theo-michel/clippy-picker/docs/bench-setup.png

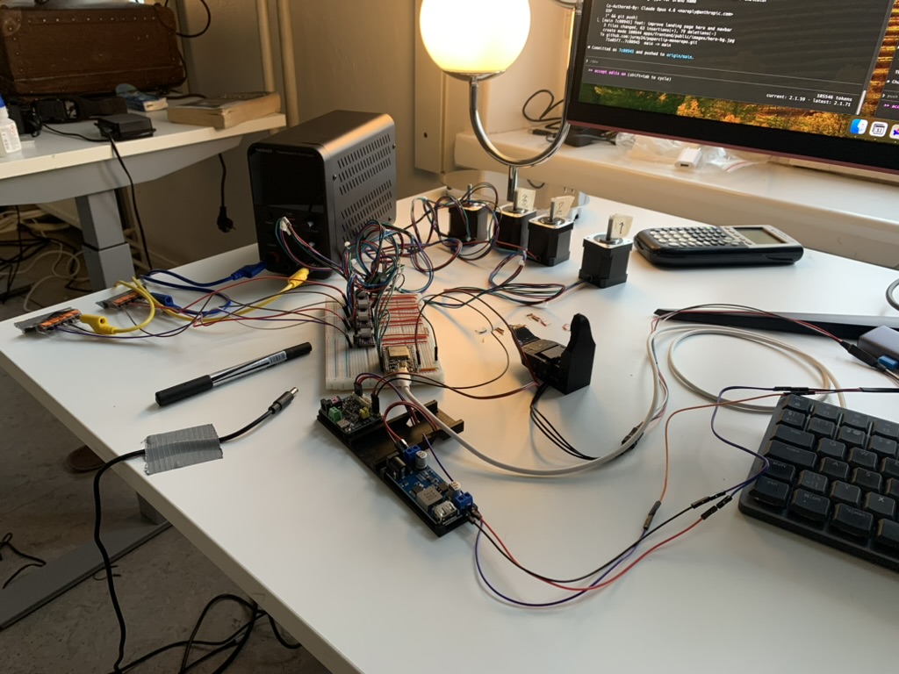
docs/bench-setup.png
