theo-michel/clippy-picker/docs/waveshare-adapter-wrong-not-uart-servo.png

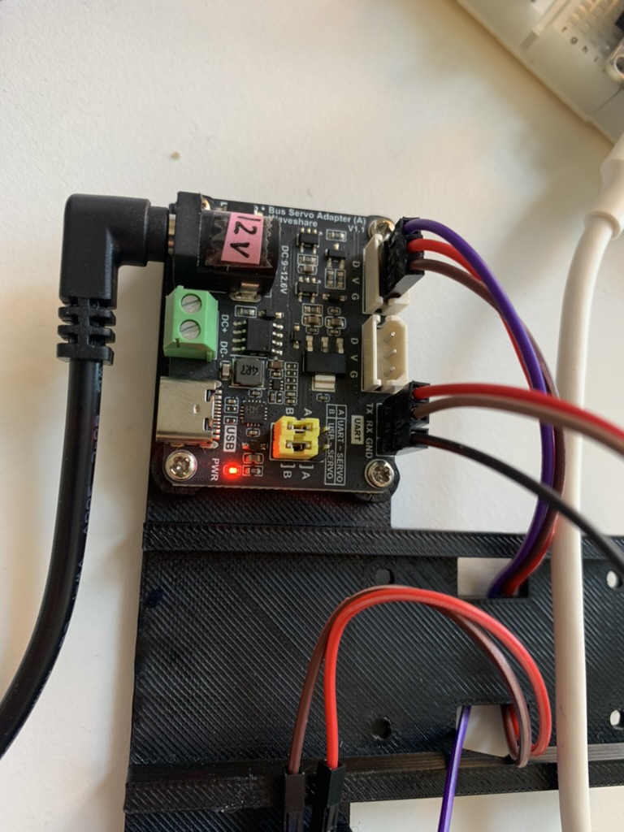
docs/waveshare-adapter-wrong-not-uart-servo.png
