theo-michel/clippy-picker/firmware/include/gripper.h

#pragma once

#include <stdint.h>
#include "config.h"

/// Feetech STS3215 gripper control over Serial2.
///
/// Provides open/close, arbitrary position control, and telemetry
/// readback (position, temperature, load).
class Gripper {
public:
    bool init();

    void open();
    void close();
    void setPosition(int32_t pos);

    int32_t getPosition();
    int32_t getTemperature();   // °C
    int32_t getLoad();          // raw current register value (mA)
    bool    isMoving();

    bool isConnected();

private:
    bool _probe();
    bool _connected = false;
};

extern Gripper gripper;
