theo-michel/clippy-picker/(commit log)

2026-02-09 Initial commit: Delta robot controller
    Arduino firmware and Python web interface for delta robot kinematics and control.
2026-02-09 Update kinematics, web controller, and HTML templates
2026-02-18 addded small arm at the bottom
2026-03-02 ♻️ replace pip with uv
2026-03-02 ✨ add calibration file
2026-03-05 ✨ create firmware test code with esp32 and 4 steppers
2026-03-08 ✨ set up working operation for all 4 motors + gripper
2026-03-08 ✨ write firmware (untested)
2026-03-09 ✨ create wifi test for esp32
2026-04-02 ✨ add gantry homing, delta enable/disable, and endstop support
    Add gantry endstop homing (move toward limit switch, set zero, back off),
    delta motor enable/disable via DRV8825 EN pin, and new serial commands
    (GANTRY_HOME, DELTA_ENABLE, DELTA_DISABLE). Update config with endstop
    pin, enable pin, corrected limits, and faster gantry speed defaults.
    Made-with: Cursor
    [config.h, motors.cpp, motors.h, protocol.cpp, protocol.h]
2026-04-02 ✨ add gripper test scripts and rewrite endstop test
    Add Dynamixel gripper test (gripper_test.cpp) and raw serial gripper test
    (gripper_raw_test.cpp) with platformio environments. Rewrite endstop test
    with interactive jogging (a/d/s/h/p), proper homing with back-off, and
    position tracking in mm.
    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
2026-04-02 ✨ add forward kinematics, coordinates module, and updated geometry
    Add forward kinematics solver (three-sphere intersection). Remove redundant
    triangles IK method, keeping only the classic approach. Add coordinates.py
    for unified firmware↔kinematic angle conversion and robot geometry defaults
    (upper_arm=150, lower_arm=268, Fd=82.5, Ed=27.3). Document joint angle
    convention (0° = horizontal, positive = down).
    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
2026-04-02 ♻️ rewrite delta_robot driver with IK integration and telemetry
    Complete rewrite: add host-side inverse kinematics (move_to_xyz,
    move_to_position), firmware↔kinematic angle conversion, structured
    telemetry (Telemetry dataclass with Dynamixel state), gantry homing,
    delta enable/disable, and blocking move helpers. Replace raw send()
    with typed command methods and proper error handling.
    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
    [delta_robot.py]
2026-04-02 ✨ add homing system with persistent home offsets
    Add homing module (run_homing_sequence, load/save home offsets from
    delta_home.json), and homing web UI template for manual homing workflow.
    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
2026-04-02 ♻️ overhaul web controller and UI
    Rewrite web controller with homing routes, telemetry endpoint, Cartesian
    move support, and delta enable/disable. Rebuild index.html with updated
    controls for the new motion API and coordinate system.
    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
2026-04-02 ✨ add workspace analysis and update calibration geometry
    Add workspace_analysis.py for mapping reachable delta workspace with
    visualization output. Update calibration.py default geometry to match
    actual robot dimensions (lower_arm=268, Fd=82.5, Ed=27.3).
    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
2026-04-02 📝 update README with homing docs, new commands, and corrected limits
    Document GANTRY_HOME command, homing workflow for gantry/delta/gripper,
    correct Z-axis direction (down), and update gantry max travel to 500 mm.
    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
2026-04-02 ✨ add STS3215 serial servo test script
    Add test script for STS3215 serial bus servo with SCServo library
    and corresponding platformio environment.
    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
2026-04-04 Replace Dynamixel gripper with Feetech STS3215 and add real-time slider control
    Swap XL330 Dynamixel for STS3215 Feetech servo across firmware and Python:
    rewrite gripper.cpp with SCServo library, update config/pins/positions,
    add retry logic to gripper init, and report GRIPPER_DISCONNECTED on failure.
    Add gripper slider + open/close buttons to dashboard, /api/grip endpoint,
    gripper cycling in rectangle sweep, and throttled real-time slider sends.
    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
    [config.h, coordinates.py, delta_robot.py, feetech_test.py, gripper.cpp, gripper.h, protocol.cpp]
2026-04-06 ✨ get camera working with windows
2026-04-06 🧩 update pins for motors for pcb design
2026-04-10 test realsense camera on bjorns computer
2026-04-11 🧩 remove legacy arduino controller
2026-04-11 🧩 update microstepping to 1/16 and update firmware angles
2026-04-11 📝 remove unnecessary documentation
2026-04-11 ✨ update homing and zeroing kinematics in code
2026-04-11 🔧 remove legacy code for dynamixel servo
2026-04-11 add camera intrinsics to gitignore (stored on bjorns computer)
2026-04-11 remove delta_home.json persistence — home angles are fixed constants
    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
    [coordinates.py, delta_robot.py, web_controller.py]
2026-04-11 ✨ add calibration UI
2026-04-12 fix forward kinematics to use effective radius (Fd - Ed)
    The elbow-to-effector sphere centres should be offset by the effective radius f = Fd - Ed, not Fd alone. This makes the FK trilateration solve directly for the effector centre.
    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
    [delta_kinematics.py]
2026-04-12 redesign calibration UI with light theme, axis swap, and home position
    Switch from dark to light theme matching the dashboard. Swap canvas axes so Y is horizontal and X is vertical, flip Y direction. Load home position from server via new /api/home_xyz endpoint and use it for Z slider limits and Home button.
    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
    [web_controller.py]
2026-04-12 fix coordinate frame: +X toward arm 1, +Z down, +Y right-hand
    Rewrites kinematics and all UI/API code to use the correct physical frame. Fixes pre-existing FK sign bug in the quadratic solver that was masked by symmetric test cases. Corrects arm 2/3 rotation order to match physical motor layout (arm 2 at +120 deg from arm 1, clockwise from above).
    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
    [coordinates.py, delta_kinematics.py, delta_robot.py, web_controller.py]
2026-04-12 fix gripper connection by lowering USB serial baud to 115200
    Running both UART0 and UART2 at 1 Mbaud caused the servo ping to fail during startup. Dropping USB serial to 115200 (matching the working test script) resolves the issue. Also removes obsolete gripper test scripts.
    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
    [config.h, delta_robot.py]
2026-04-12 merge calibration + homing wizard into single dashboard page
    Consolidate the three separate pages (dashboard, calibration, homing)
    into one full-viewport dashboard with:
    - Homing wizard as a modal (triggered from topbar button)
    - Camera feed + XY workspace with Z lever and gantry slider
    - Gripper, computed angles, and actions in a controls row
    - Client-side IK engine for live drag-to-move
    - /homing and /calibration routes now redirect to /
    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
2026-04-12 ✨ add calibration and new UX
2026-04-13 perform an extrinsic camera calibration (poor rmsd)
2026-04-13 add automatic calibration script
2026-04-13 remove unused code across python and firmware
    - remove unused imports (make_transform, field, math, Tuple)
    - remove dead home_full() method from DeltaRobot (web controller calls run_homing_sequence directly)
    - remove unused DEFAULT_HOME constant from coordinates
    - remove unused NUM_MOTORS define from firmware config
    - delete scripts/calibration.py (outdated standalone script)
    - move kabsch into calibration/ and delete transforms.py
    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
2026-04-13 add YOLO object detection with tray-based pick flow
    - ObjectDetector wraps YOLOv11n with lazy loading and custom weight support
    - camera_to_robot() loads saved calibration transform for coord conversion
    - TrayRegion definitions (world-frame mm) for 6-tray 2x3 grid layout
    - /api/detect/scan and /api/detect/pick endpoints with tray filtering
    - TCP motion methods on DeltaRobot (move_tcp, move_to_position_tcp)
    - Detection overlay on MJPEG camera stream
    - Training image capture script for dataset collection
    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
2026-04-14 add pick test workflow and improve camera depth + serial robustness
    - Add pick test UI modal and SSE-driven backend sequence
    - Add median-filtered depth patch to camera deprojection
    - Serialize serial port access with lock in DeltaRobot._command
    - Add detection overlay toggle to camera feed UI
    - Update camera calibration transform and default YOLO weights path
    - Add gripper init delay for connection reliability
    - Add standalone test_pick.py script
    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
2026-04-14 🧩 mmlove camera calibration and yolo training script
2026-04-16 ♻️ reorganize scripts and camera files
2026-04-17 Add MQTT factory edge bridge and auto-detect stereo camera
    New factory_edge.py runs alongside web_controller as an MQTT bridge with
    a state machine for orchestrator integration. Camera now auto-scans
    indices 0-9 to find the stereo feed when the default index fails.
    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
    [camera.py, factory_edge.py, test_stereo.py, web_controller.py]
2026-04-18 Extract pick sequence into pick.py and add transform debug view
    - Move pick-and-return logic out of web_controller.py into pick.py as a
    pure generator, keeping the web route as a thin SSE wrapper
    - Rename /api/test/pick -> /api/pick
    - Add /api/debug/pick_transform and a Debug Transform modal that
    overlays calibration points on camera and delta frames
    - Re-run extrinsic calibration (rmsd 27.7 -> 10.6)
    - Fix camera.deproject(): drop spurious mm/m round-trip and sign-flip
    cx/cy so X,Y match OpenCV convention
    - Simplify camera init: default to index 0, drop stereo auto-detect
    - Gripper: lazy-reconnect via _probe() so isConnected() recovers if
    the servo comes online after init
    - factory_e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
    [camera.py, factory_edge.py, gripper.cpp, gripper.h, pick.py, web_controller.py]
2026-04-18 Point cloud display Replace with VLA
    [camera.py, coordinates.py, factory_edge.py, object_detection.py, pick.py, web_controller.py]
2026-04-20 Add preflight checks with MQTT report
    Adds a `preflight` command handler to the factory edge that runs a
    deterministic set of probes (connection, zeroed, homed, camera,
    calibration, transporter-in-frame, gripper cycle) and publishes a
    `PreflightReport` on `factory/machines/picker/preflight`.
    Each check is tagged `fixable_by: agent|human` so the orchestrator
    can auto-recover what it can and surface the rest to a human.
    The gripper probe only runs when the edge state machine is IDLE.
    Web controller now tracks `zeroed` per session so preflight has a
    single source of truth.
    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
    [factory_edge.py, preflight.py, web_controller.py]
2026-04-20 Simplify picker dashboard and drop PLY point cloud export
    The PLY download path was a one-off debugging aid that never fit the
    normal workflow. Remove the `get_pointcloud_ply` method, the Flask
    endpoint, the `pointcloud_preview.py` script, and the dashboard button
    and handler.
    Also clean up the dashboard topbar: merge the middle and right zones
    into one action row, drop the now-stale `CORE_MODULES` strap, bump the
    version label, and a few minor copy tweaks.
    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
2026-04-20 Generalise edge to MachineResult RPC and trim web_controller
    factory_edge now exposes a handler-dispatch pattern with a MachineResult
    envelope on factory/machines/picker/results: any command with a
    request_id gets a structured ok/detail/data response. Adds handlers for
    home, cycle_gripper, open/close_gripper, start_camera, reconnect,
    look_camera, cancel_task, pause, and resume, with per-request dedup.
    preflight drops the fixable_by field — whether a failure is
    agent-fixable is a function of the agent's tools, not a property of the
    probe. Also removes the transporter_in_frame VLM probe.
    web_controller sheds unused surface area (command log, speed/accel
    state, /homing and /calibration redi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
    [factory_edge.py, preflight.py, web_controller.py]
2026-04-20 Cut VLM pointing latency with cheap wins
    Swap to stable gemini-2.5-flash, downscale frames to 640 px long edge
    before upload, and drop JPEG quality to 75. Image is tokenised for
    vision prefill, so shrinking it is where most of the TTFT savings come
    from; the returned 0-1000 coords are resolution-independent so
    full-res depth deprojection is unaffected.
    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
    [object_detection.py]
2026-04-27 Enhance run script and improve gripper handling
    Updated run.sh to allow dynamic port selection and fallback if the default port is busy. Enhanced delta_robot.py with a new wait_for_gripper method to ensure the gripper has settled before proceeding. Adjusted factory_edge.py and other files to utilize the PICKER_PORT environment variable for consistent base URL configuration. Improved pick.py to call the new gripper wait method, ensuring safe operation during the pick sequence.
    This update improves robustness and flexibility in handling connections and gripper operations.
